HuggeK/openflight/cad/IARC_case/README.md

- M5 Bolts needed: 10
- M2.5 Bolts needed: 12

Instructions for OpenFlight IARC v3 Case Build
  
1. Print out `sensor_housing.stl` 
2. Print out (2x) `OPS_mount.stl` 
3. Secure the OPS sensor to each `OPS_mount.stl` part with screws (I don't know which ones)
4. Secure the `OPS_mount.stl` parts to the `sensor_housing.stl` part with (2x) M5 bolt 
5. Fit the sound sensor into the little slot on the left side of the `sensor_housing.stl` part. 
6. Print out (1x) `KLD7_h_mount_L_v2.stl` and (1x) `KLD7_h_mount_R_v2.stl` 
7. Slot a KLD7 sensor between the mount parts, and secure them to the `sensor_housing.stl` part with (2x) M5 bolt 
8. Print out (1x) `KLD7_v_mount_L_v2.stl` and (1x) `KLD7_v_mount_R_v2.stl` 
6. Slot a KLD7 sensor between the mount parts, and secure them to the `sensor_housing.stl` part with (2x) M5 bolt 
7. Print out the `monitor_mount.stl` part. 
8. Print out (4x) `monitor_standoffs.stl`'s. 
9. Secure each `monitor_standoff.stl` part to the corners of the `monitor_mount.stl` part with (1x) M2.5 bolt. 
10. Secure the monitor to the `monitor_mount.stl` part. 
11. Secure the raspberry Pi to the monitor. 
12. Print out the `monitor_shell.stl` part. If you use the Raspberry Pi Touch Display 2 instead of the 7" HMTECH touchscreen, print `monitor_shell_rpi_touch_v2.stl` instead. 
13. Secure the monitor assembly inside the `monitor_shell.stl` part with (4x) M2.5 bolts at the corners. 
14. Print out the `monitor_back.stl` part. 
15. Secure the `monitor_back.stl` part to the `monitor_standoffs.stl` parts with (4x) M2.5 bolts. 
16. Slide the whole assembly into the sensor housing assembly, using the dovetails to align everything together. 
17. Print out the `name_plate.stl` file. 
18. Secure the `name_plate.stl` file to the front of the whole assembly with glue. 
19. Print out the `curvy_backplate.stl` file. 
20. Secure the `curvy_backplate.stl` file to the whole assembly with (4x) M2.5 bolts. 
21. Print out (4x) `case_foot.stl` parts. 
22. Secure each foot to the bottom of the whole assembly with (4x) M5 Bolts. 

And that’s how you put together the 3d printed parts!
