HuggeK/openflight/cad/IARC_case/stl/monitor_shell_rpi_touch_v2.stl

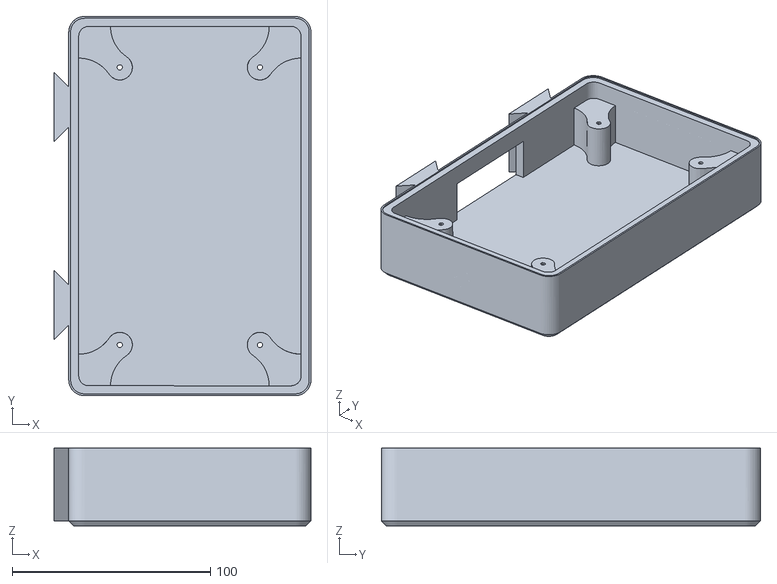
[picture p1: CAD file, 2026-07-03]
cad/IARC_case/stl/monitor_shell_rpi_touch_v2.stl
129.7 x 191.4 x 39.2
