HuggeK/openflight/(commit log)

2026-07-03 feat(cad): add IARC monitor shell for Raspberry Pi Touch Display 2
    Add monitor_shell_rpi_touch_v2.stl alongside the existing monitor_shell.stl
    so the IARC case can be built with the Raspberry Pi Touch Display 2
    (7" 720x1280, MIPI DSI, Raspberry Pi 5 compatible).
    STL contributed by @thecrowbar, imported byte-identical from
    thecrowbar/openflight-rpi-touchscreen_v2@c958069.
    Also document the display option in the IARC build instructions and
    the parts list.
    Refs jewbetcha/openflight#101
    [monitor_shell_rpi_touch_v2.stl]
2026-08-29 docs(parts): fill the gaps a build order exposed
    Builders order from PARTS.md, so a part that is needed in practice but
    missing, unnamed, or unlinked becomes a second order and a second wait.
    Working through a build surfaced several.
    New rows:
    - Raspberry Pi Active Cooler (SC1148, ~$8). The kiosk drives the UI,
    rolling-buffer capture, and FFT processing continuously, and a
    passively cooled Pi 5 throttles under that sustained load.
    - STEMMA QT / Qwiic-to-Qwiic cable (~$1). The section already covered
    wiring the LIS3DH at the Pi but not mounting it elsewhere, which is
    the actual use case for a tilt sensor. Length is left TODO because it
    depends on the enclosure and the case is stil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
2026-09-04 docs(parts): add the X1202 power button and a complete-build total
    The Geekworm X1202/X1206 expose their external power button on an XH2.54-2P header that wants a momentary switch, and the list named the HAT but not a button for it. Add Geekworm's PSW12, a 12 mm momentary button pre-wired with the XH2.54 lead, so nothing needs soldering, and give the X1202 row an Amazon link beside the Geekworm one so the HAT can ride in the Amazon order.
    Add an optional-extras line and a complete-build total to the Cost Summary so the everything-included price (angle radar, inclinometer, tripod, UPS with four estimated 18650 cells, button, camera) is on the page.
    Claude-Session: https://claude.ai/code/ses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
2026-09-04 docs(parts): drop the tripod row and name the 12 mm power button plainly
    The Tripod Mount row was an unlinked placeholder for a part the build does not use, so remove it and take it out of the optional-extras line and the complete-build total (now ~$685). Rename the Geekworm button row so the part reads as a button with the PSW12 code in parentheses, instead of a bare code that reads like another UPS.
    Claude-Session: https://claude.ai/code/session_01Y55yaLV4h2SVf5EVHN7Yz8
2026-09-04 docs(parts): list the 12V DC adapter that feeds the X1202 at full output
    The X1202 accepts 6-18V DC at 3A or more on its 5.5 x 2.1 mm barrel jack (or 5V 5A on USB-C, never both at once) and converts it to the 5.1V 5A the Pi 5 needs. Add Geekworm's PSU60 12V 5A adapter as the barrel-jack supply, with its Amazon listing so it fits the Amazon order, and note under the Cost Summary that it replaces the 27W USB-C supply rather than adding to the total.
    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
2026-09-04 docs(parts): drop the Qwiic-to-male-headers cable row
    The Adafruit 4209 row was a workaround for not knowing the Qwiic-to-Qwiic length yet; it is not needed, so remove it from the inclinometer table. It was never in the totals, so nothing else moves.
    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
2026-09-04 docs(parts): make the X1202 DC adapter row a spec with examples
    At 12V the X1202 only needs a 3A (36W) adapter to deliver its 5.1V 5A output, so the row now states the requirement (12V, 3A or more, center-positive 5.5 x 2.1 mm) instead of naming Geekworm's 5A unit as the part. Link the MEAN WELL GST36 (EU and US plug, at Mouser) and Geekworm's PSU60 (Amazon) as examples so it stays orderable.
    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
2026-09-04 docs(parts): note the PR #221 trigger path and the Qwiic chain to the DS3502
    PR #221 adds an opt-in OPS243 internal hardware trigger (firmware v1.3.1) that needs no SEN-14262, so call it out in the Sound Trigger section as an optional path that is not merged yet, and say under the Cost Summary that the Sound Trigger line drops out on that path. Totals are unchanged.
    Document that the Qwiic-to-Dupont cable's chain can continue from the LIS3DH's second STEMMA QT socket further down to the DS3502 digital potentiometer, and give the DS3502 row that wiring plan plus the note that it is moot if the sound trigger goes away.
    Claude-Session: https://claude.ai/code/session_01Y55yaLV4h2SVf5EVHN7Yz8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
2026-09-04 docs(parts): explain the 5V 5A supply requirement and the UPS barrel-jack alternative
    The Pi 5 only releases its full downstream USB budget, which the two radars need, when the supply negotiates 5A at 5V, so say the 27W supply must be that unit, that ordinary PD chargers stop at 3A, and that USB-C extensions through the case cause sag and failed negotiation. Add a note that with the X1202/X1206 fitted any adequate barrel-jack supply replaces the 27W unit, the UPS provides 5.1V 5A over the pogo pins with PSU_MAX_CURRENT=5000 set by the setup script, and the barrel jack is the better input for a cased build. Totals unchanged.
    Claude-Session: https://claude.ai/code/session_01Y55yaLV4h2SVf5EVHN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
2026-09-04 docs: add UPS safety rules for charging temperature and power inputs
    Add a safety note to the parts list and the Geekworm operator guide: never charge the 18650 cells below 0 C (lithium plating permanently damages them and can make them unsafe), never connect the UPS USB-C input and barrel jack at the same time, and when powering from USB-C plug into the UPS board rather than the Pi. The operator guide already carried the last two rules; the below-freezing rule is new in both places.
    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
2026-09-04 docs(parts): move female/female jumper rows to SparkFun PRT-12796
    Adafruit 794 (Mouser 485-794) cannot be found at Mouser, so the two female/female jumper rows now point at SparkFun PRT-12796 (Mouser 474-PRT-12796), a 150 mm connected F/F pack. The Sound Trigger line and the totals follow its 2.75 USD list price.
    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
2026-09-04 docs(parts): add the Adafruit 1445 + 1152 button alternative and the momentary rule
    The X1202 power-button row now says the switch must be momentary, and a new row lists the Adafruit 1445 16 mm momentary button with the 1152 JST XH to 0.11 in quick-connect leads as the Mouser-orderable, solder-free alternative to the Geekworm PSW12 (16 mm hole instead of 12 mm).
    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
2026-09-04 docs(parts): make the Adafruit 1445 + 1152 pair the X1202 power-button row
    The Geekworm-direct button is dropped because it cannot be ordered through Mouser or Amazon. The optional-extras line and the complete-build total follow the Adafruit pair's price.
    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
2026-09-04 docs(parts): move the Qwiic-to-Qwiic cable next to the DS3502 it serves
    The STEMMA QT / Qwiic-to-Qwiic cable is the link from the LIS3DH's second socket down to the DS3502 digital potentiometer for the sound-trigger gain research, not an inclinometer placement cable, so it moves from the inclinometer table to the Optional table beside the DS3502. The inclinometer line and the complete-build total drop by its price.
    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
2026-09-04 docs(parts): size the X1202 DC adapter by power across its 6-18V range
    The adapter row no longer says a 12V supply simply works. It states the rule as power: the X1202 needs about 36W anywhere in its 6-18V input range, so the current an adapter must be rated for rises as its voltage falls (2A at 18V, 3A at 12V, 4A at 9V, 6A at 6V), a 12V adapter under 3A or a 9V adapter at 3A browns out under charging plus two radars, and below about 9V the current exceeds a 5.5 x 2.1 mm plug's usual rating. The UPS note under Power & Accessories carries the same figures.
    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
2026-09-04 docs(parts): state the X1202 adapter requirement as Geekworm's 3A, not a derived 36W
    Geekworm specifies the DC input as 6-18Vdc at 3A or more and publishes no wattage, so the row now repeats that and explains what 3A buys at each voltage from the actual loads (Pi 5 up to 25.5W, charging up to about 12W): 12V runs and charges at once, 9V runs but charges slowly under load, 6V cannot carry a full Pi load. A little over 25W runs the Pi but does not also charge at full rate.
    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
2026-09-04 docs(parts): add an X1206 cost breakdown and fill in the X1206 row
    The cost summary gains an optional-extras line and a complete-build total for a build with the X1206 instead of the X1202 (52 USD HAT, four 21700 cells at about 8 USD, the same button pair and camera). The X1206 row replaces its Varies placeholder with Geekworm's page and wiki facts: on-board 21700 holders, unprotected cells only, 9-18V DC input, 5V 5A USB-C, same XH2.54 button header, Geekworm-direct order.
    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
2026-09-09 docs(parts): fill the gaps a build order exposed
    Parts-list maintenance from a build. Add the parts it turned out to need
    (Pi Active Cooler, jumper ribbons by gender, Qwiic cabling for the
    LIS3DH and DS3502, an X1202/X1206 power button, a DC barrel-jack
    adapter), name the rows that said Any or TODO, explain why the 27W
    supply must negotiate 5V 5A and how the UPS HAT replaces it, add UPS
    safety rules to the parts list and the Geekworm guide, fill in the X1206
    row, drop the tripod placeholder, and recompute the totals with
    complete-build lines.
    The Geekworm guide test read that guide as ASCII and the new 0 °C note
    is its first non-ASCII character, so both battery guides are now read
    as UTF-8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
2026-09-09 docs(parts): size the cables on the v2 enclosure and add a filament estimate
    Measured on the 2026-09-09 Onshape export of the v2 back housing: the insert
    pockets and standoffs locate the OPS243, IWR6843LEVM, X1202 + Pi stack,
    LIS3DH pad, camera and button, and the sound detector sits on the back of the
    screen in the front half. A new Cable Lengths section lists every run with
    straight-line, routed and buy lengths.
    Consequences in the rows: the female/female jumper pack moves from 150 mm
    (PRT-12796) to 300 mm (SparkFun PRT-09389) because the detector-to-OPS243
    HOST_INT run is ~175 mm routed and the front half lifts off for service; the
    micro-USB row gets 250-300 mm; the DS3502 Qwiic-to-Qwiic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
2026-09-09 docs(parts): cost the enclosure inserts, screws and plungers, and print the case in PETG
    Add an Enclosure Hardware table: 24 PEM SI IUTB-M2.5, 4 IUTB-M2 and 2
    IUTB-M3 brass heat-set inserts (counted from the v2 back-housing pockets
    plus the front housing and kickstand as drawn), the Keystone 29301 M2.5x6,
    APM HEXSEAL M2x4 and Keystone 29314 M3x12 screws, #4 washers, the eight
    M2.5x35 DIN 912 through-bolts, and the two 3 x 4 mm press-fit ball plungers
    for the kickstand detent, with where each goes and a ~$35 line in the
    totals. Parts follow openflight-enclosure#4; prices are from Bossard,
    DigiKey and J.W. Winco because Mouser walls fetches, and the Mouser
    minimum-quantity caveat for PEM inser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
2026-09-09 docs(parts): correct the case DC-jack run, measured from the shelf
    The panel jack sits in the top shelf at Y +83, not in the top wall, so the
    run to the X1202 barrel jack is ~145 mm straight and ~205 mm routed rather
    than 165 / 220; the 250 mm buy length is unchanged.
    Claude-Session: https://claude.ai/code/session_01UGrnsyu4nYvf37z6NtQGhj
2026-09-09 docs(parts): accept the 1152 button leads on the straight run
    Button hole to the X1202 PSW header is ~180 mm in a straight line across
    the Pi stack, so the Adafruit 1152's 200 mm leads reach with ~20 mm to
    spare. The routed detour (~250 mm) is not needed for this one cable, so
    the row's open item is closed and the Cable Lengths table says which
    lead to use. Every other run keeps its routed basis.
    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
2026-09-09 docs(parts): collapse the cable-length measurements
    The parts rows already say which length to buy, so the Cable Lengths
    section keeps its heading and a one-line pointer and folds the
    measurement text and the run table into a details block, the way the
    setup pages fold their manual steps. Ordinary builders can skip it; the
    links from the jumper rows still land on the heading.
    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
2026-09-21 docs(parts): bring the parts list in line with the v3 case and Mouser
    Add the 200 mm Raspberry Pi display cable (SC1131) the Touch Display 2
    needs in the openflight-enclosure v3 case, where the Pi and UPS mount to
    the shell rather than the screen and the ~100 mm ribbon in the box does
    not reach (openflight-enclosure#11).
    Document power input on the v3 case: the shell has no USB-C opening, so
    a USB-C supply is captive and a detachable supply is the DC route. Add
    the no-solder parts for it (a pre-wired 5.5 x 2.1 mm panel jack, Tensility
    10-03609 on Mouser or Amazon DC-099 kits; two Wago 221-412 for the XH
    header option; the Adafruit 369 screw-terminal plug for the barrel option
    into the X1202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
2026-10-20 feat(ops243): flash OPS243 firmware from the Pi through a J-Link
    Add firmware/flash_ops243.py, a replacement for Infineon's XMC Flasher that
    drives a SEGGER J-Link (the EDU Mini is enough) through J-Link Commander.
    The 1.3.2 update needed for the internal hardware trigger no longer needs a
    Windows PC, Java/JavaFX or XMC Flasher; plug the probe into the Pi instead.
    - Detects the MCU from the XMC4 SCU_IDCHIP register (XMC4500/XMC4700) and
    refuses an explicit --device that contradicts the chip.
    - Validates the Intel HEX (checksums, EOF, overlaps) and refuses images that
    fall outside the selected part's flash.
    - Never issues a full-chip erase; loadfile only rewrites covered sectors.
    - Verif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
2026-10-29 docs: redraw OPS243 UART wiring without sound trigger, add Pi 5 header map
    Replace the OPS243 UART wiring diagram with a build that has no sound
    trigger: the OPS243 is drawn upside down with its J3 pins pointing up
    and the micro-USB to their left, the Pi 5 is rotated so its USB ports
    face up, and the J3 pin 1 detection output runs to Pi pin 12 (GPIO18).
    Add a Pi 5 GPIO header map for the same build: OPS243, LIS3DH, display
    power, the Geekworm X1202 pogo pins, and the CAM/DISP ribbon connectors.
    Claude-Session: https://claude.ai/code/session_01WDYU7DjLVnHaiHM6Fz8BtM
2026-10-29 docs(iwr6843): draw the S1 boot switch for flashing and functional mode
    Add a diagram of the IWR6843LEVM's six-lever S1 DIP switch as it reads on
    the board (ON printed along the top edge by the solder legs, levers 1-6
    left to right), with the flashing and functional settings one above the
    other. Only S1.1 changes; S1.6 is unused; RESET is the S2 push button.
    The flashing guide shows it in step 2 and points back to it in step 5.
    Claude-Session: https://claude.ai/code/session_01MVm7Tmc6mv2Hd99ubcGeua
2026-10-29 docs(iwr6843): show S1 as it faces you on the mounted board
    Rotate the S1 boot switch diagram 180 degrees to match the board as seen
    in the case: levers 6 to 1 left to right, S1.1 at the right end, and the
    ON print with the solder legs along the bottom, so down is on. Text stays
    upright. The flashing guide's alt text and caption follow.
    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
2026-10-29 docs(iwr6843): print the S1 switch markings in the boot switch diagram
    Draw what the switch body says, upside down as it reads on the mounted
    board: lever numbers 6 to 1 along the top, CTS, 15 and ON along the edge
    by the solder legs, plus the board's S1 silkscreen, so a reader can match
    the drawing to the part. The flashing guide's alt text and caption
    describe the markings.
    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
2026-10-29 fix(battery): rebuild wfplug-batt taskbar plugin on pplug-batt 1.11
    Raspberry Pi OS updates wfplug-batt to 1.11, which still ignores the
    MAX17040 capacity value, and the bundled 1.3+openflight4 build can neither
    be reinstalled (apt refuses the downgrade) nor load in wf-panel-pi 1.43.
    - Rebuild the plugin from pplug-batt 1.11 (c622de2) plus the existing
    capacity/online patch as 1.11+openflight1, built on an arm64 Trixie Pi.
    - Add scripts/battery/build_wfplug_batt.sh so the rebuild is repeatable.
    - setup.sh: warn that a rebuild is needed when the installed upstream
    plugin is newer than the bundled one instead of attempting a downgrade,
    and replace the misleading 'incompatible with this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
2026-10-30 feat(battery): optional low-battery shutdown service
    The X1202/X1206 take unprotected cells and OpenFlight's 20%/10% warnings
    are informational, so nothing stops a UPS build from draining the cells.
    Add scripts/battery/battery_guard.sh, run as a systemd service by
    scripts/battery/install_battery_guard.sh. When external power is offline
    and the battery is at or below 10% or 3.40 V for three readings 20 s
    apart, it stops OpenFlight and runs systemctl poweroff. It never acts on
    external power or when the battery or charger state is unreadable.
    Limits live in /etc/default/openflight-battery-guard.
    It reads the standard /sys/class/power_supply devices, so it is
    provider-agnostic, and stays a se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
2026-10-30 docs(battery): warn against charging below freezing next to the battery warnings
    The operator guide already warns not to charge the UPS cells below 0 °C,
    but the Battery Monitoring page that explains the low-battery warnings did
    not. Repeat the warning there, where a user reacting to a low-battery
    warning on a cold day will read it, and link the full cell warnings.
2026-10-30 feat(ui): warn against charging below freezing in the low-battery popups
    Show 'Do not charge the batteries below 0 °C (32 °F)' in the 20% and 10%
    warning dialogs, where a user about to plug the unit in on a cold day sees
    it, in all four UI languages. No-break spaces keep 0 °C and 32 °F on one
    line. Refresh the docs screenshots of both dialogs.
2026-11-02 fix: build Pi .venv on system Python and drop the 3.11 pin
    The .python-version pin made every plain `uv sync` / `uv run` rebuild .venv on 3.11, away from the system Python (3.13 on Trixie) that Raspberry Pi OS's Picamera2/libcamera bindings are built for, breaking --camera-capture. Pinning 3.13 instead would break Bookworm Pis the same way, so the pin is removed.
    On a Pi, setup.sh now builds .venv on /usr/bin/python3 with system site-packages (and repairs a venv built any other way) via scripts/setup/system-python-venv.sh, and reports the venv's Python. CI adds Python 3.13. The scattered UV_PYTHON workaround in the docs and example wrapper is replaced by one Python Environment section in th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
